LeoL-616/ESP32-Based-Portable-Signal-Analyzer/README.md

# Portable ESP32-Based Signal Acquisition and Analysis Platform

## Overview

This project aims to design and implement a low-cost portable signal acquisition and analysis platform using an ESP32 microcontroller.

The system integrates an analog front-end circuit, embedded ADC sampling, and Python-based signal processing to capture analog signals, visualize waveforms, and perform frequency-domain analysis using Fast Fourier Transform (FFT).

The project explores the complete workflow of an electronic system, including analog circuit design, PCB development, embedded programming, and data analysis.

## Motivation

Electronic measurement instruments such as oscilloscopes and spectrum analyzers are essential tools in electrical engineering but can be expensive and inaccessible for students and hobbyists.

This project aims to develop a low-cost alternative for educational and experimental purposes while gaining practical experience in mixed-signal hardware design.

## System Architecture

The system consists of four main components:

Analog Front End + ESP32 ADC Sampling + UART Communication + Python Signal Processing 

## Features

Planned features:

- Analog signal acquisition
- Adjustable signal conditioning
- ESP32-based ADC sampling
- Real-time data transmission
- Waveform visualization
- Frequency spectrum analysis using FFT

## Hardware

Main components:

- ESP32 development board
- Operational amplifier based analog front-end
- Signal conditioning circuits
- Custom PCB (planned)

## Software

### Embedded

- ESP32 firmware
- ADC sampling
- Serial communication

### Data Analysis

- Python
- NumPy
- Matplotlib
- FFT-based frequency analysis

## Project Status

Currently in the planning and system design phase.

Completed:
- Project concept definition
- Initial system architecture
- Requirement specification

In progress:
- Hardware design
- ESP32 ADC testing
- Analog front-end simulation

## Future Improvements

Potential future extensions:

- Improved ADC performance
- Battery-powered operation
- Portable enclosure design
- Additional sensor-based applications

## Documentation

Detailed engineering documents can be found in:

`/docs`

including:

- Project Requirements Specification
- System Architecture Design
- Hardware Design Notes
- Testing Reports
