LeoL-616/ESP32-Based-Portable-Signal-Analyzer/ADC/results/1kHz_spectrum.png

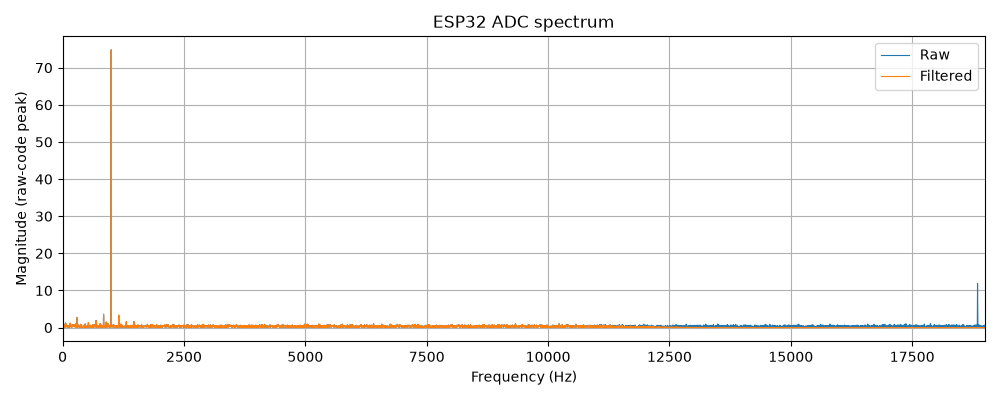
ADC/results/1kHz_spectrum.png
