LeoL-616/ESP32-Based-Portable-Signal-Analyzer/ADC/results/5kHz_spectrum.png

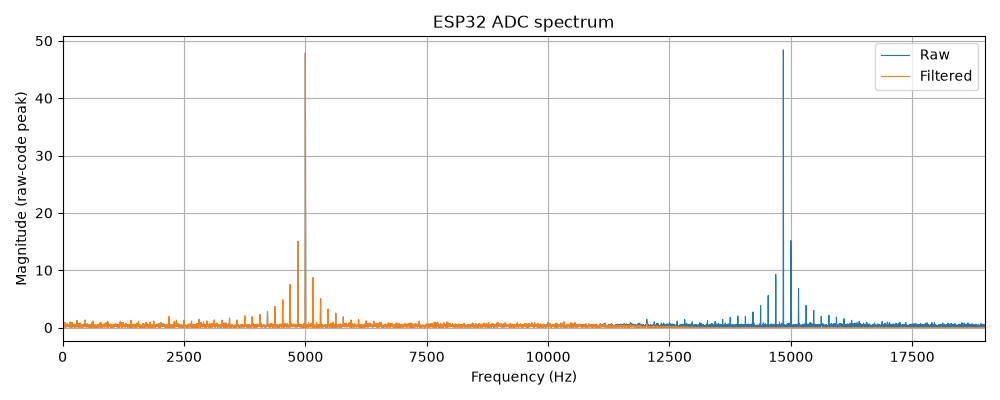
ADC/results/5kHz_spectrum.png
