LeoL-616/ESP32-Based-Portable-Signal-Analyzer/ADC/results/10kHz_spectrum.png

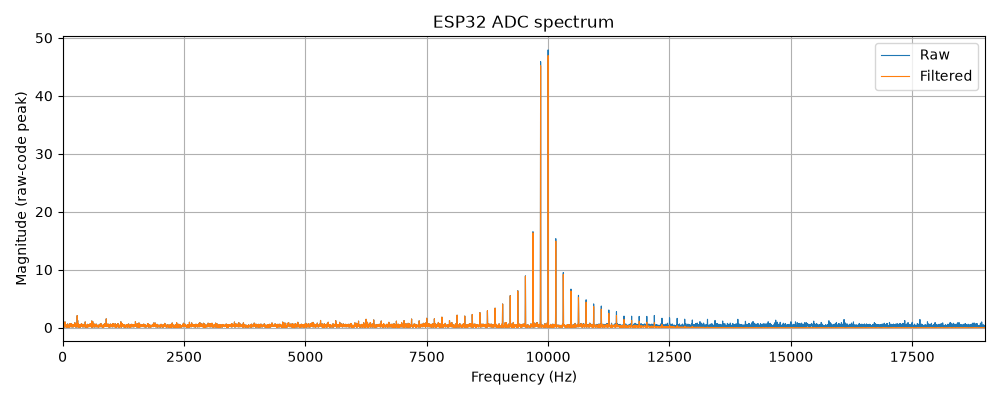
ADC/results/10kHz_spectrum.png
