LeoL-616/ESP32-Based-Portable-Signal-Analyzer/AFE/results/frequency_response/r9_comparison.png

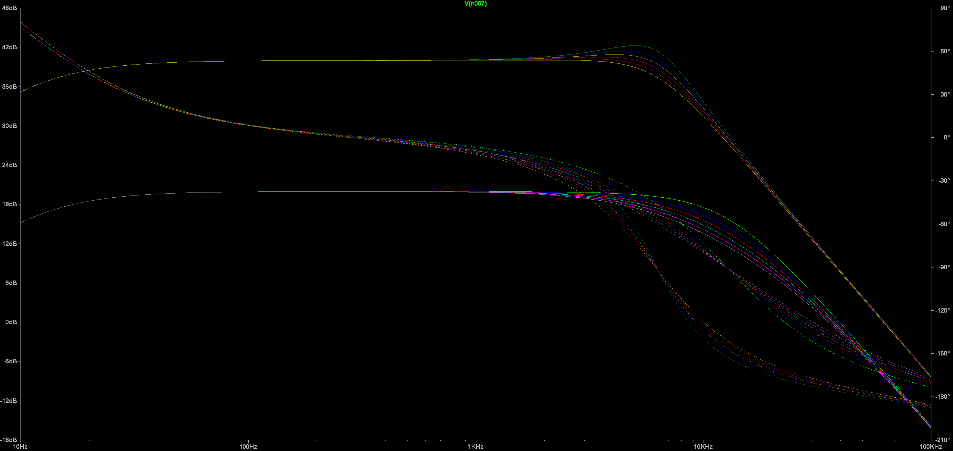
AFE/results/frequency_response/r9_comparison.png
