LeoL-616/ESP32-Based-Portable-Signal-Analyzer/AFE/results/gain/gain.png

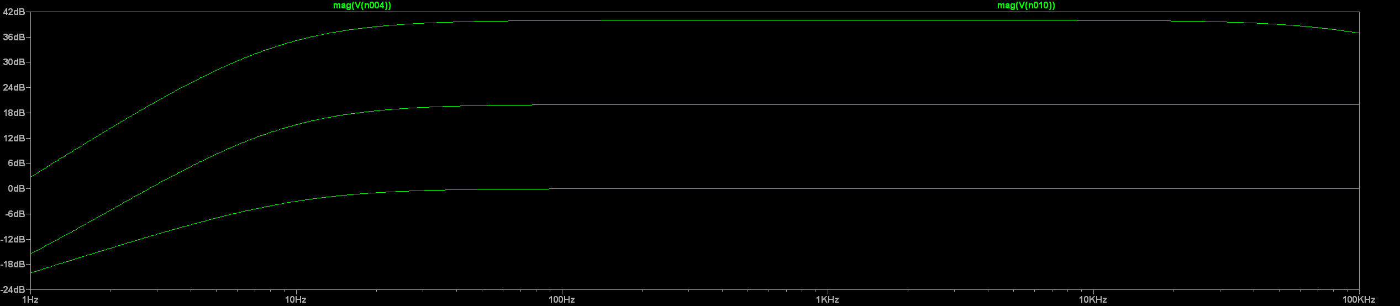
AFE/results/gain/gain.png
