LeoL-616/ESP32-Based-Portable-Signal-Analyzer/AFE/AFE_gain_test.asc

C1: cap; 10n
C2: cap; 22µ
R1: res; 9k
R2: res; 1k
R3: res; 10k
R4: res; 10k
R5: res; 1.6Meg
R7: res; 2.2k
U1: UniversalOpAmp2; Avol=713k GBW=10Meg Slew=7Meg
U2: UniversalOpAmp2; Avol=713k GBW=10Meg Slew=7Meg
V2: voltage; 3.3
V3: voltage; SINE(0 100m 1k); AC 1
Named nets: 0, -V, +V, VBIAS
.tran 0 10m 1m
