LeoL-616/ESP32-Based-Portable-Signal-Analyzer/AFE/schematic/AFE_complete.asc

C1: cap; 10n
C2: cap; 22µ
C5: cap; 4.7µ
D1: schottky; BAT54
D2: schottky; BAT54
L2: ind; 22µ; Rser=1m
R1: res; 9k
R2: res; 1k
R3: res; 10k
R4: res; 10k
R5: res; 1.6Meg
R7: res; 2.2k
R9: res; 4.3
U1: UniversalOpAmp2; Avol=713k GBW=10Meg Slew=7Meg
U2: UniversalOpAmp2; Avol=713k GBW=10Meg Slew=7Meg
V2: voltage; 3.3
V3: voltage; AC 1
Named nets: 0, -V, +V, VBIAS
