LeoL-616/ESP32-Based-Portable-Signal-Analyzer/AFE/simulation/tolerance/AFE_tolerance.asc

C1: cap; 10n
C2: cap; 22µ
C5: cap; {Cval}
D1: schottky; BAT54
D2: schottky; BAT54
L2: ind; {Lval}; Rser=1m
R1: res; 9k
R2: res; 1k
R3: res; 10k
R4: res; 10k
R5: res; 1.6Meg
R7: res; 2.2k
R9: res; {Rval}
U1: UniversalOpAmp2; Avol=713k GBW=10Meg Slew=7Meg
U2: UniversalOpAmp2; Avol=713k GBW=10Meg Slew=7Meg
V2: voltage; 3.3
V3: voltage; AC 1
Named nets: 0, -V, +V, VBIAS
.ac dec 1000 10 100k
.meas AC M10k FIND V(n007) AT=10k
.meas AC M20k FIND V(n007) AT=20k
.step param Rval list 4.257 4.3 4.343
.step param case list 1 2 3
.param Lval=if(case==1,22u,if(case==2,17.6u,26.4u))
.param Cval=if(case==1,4.7u,if(case==2,4.23u,5.17u))
