LeoL-616/ESP32-Based-Portable-Signal-Analyzer/(commit log)

2026-08-12 Update AFE component selection details
    Expanded the component selection details for the AFE, including specifications and rationales for various components such as operational amplifiers, diodes, resistors, capacitors, and inductors. Enhanced clarity and completeness of the document.
2026-08-13 Add AFE documentation to README.md
    Added detailed documentation for the Analog Front-End (AFE) including overview, architecture, input stage, gain stage, and output filter.
2026-08-15 Add AFE_tolerance circuit simulation file
    This file contains a circuit simulation with various components including resistors, capacitors, and operational amplifiers, along with measurement and parameter steps.
2026-08-15 Enhance README with simulation and verification details
    Added sections for simulation and verification of AFE, including gain settings, input protection, and frequency response analysis. Updated gain stage details and component tolerance analysis.
2026-10-02 Update and rename ADC/schematic.md to README1.md
2026-10-03 Enhance README with ADC interface and configuration details
    Added detailed interface and acquisition configuration for ADC setup, including signal connections, parameters, and verification results.
2026-10-04 Add README documentation for ESP32 firmware
    Added detailed documentation for the ESP32 acquisition firmware, including purpose, source layout, acquisition path, build instructions, startup behavior, packet ownership, and current limitations.
